loliamro/guardband-ai-fall-detection/5.JPG

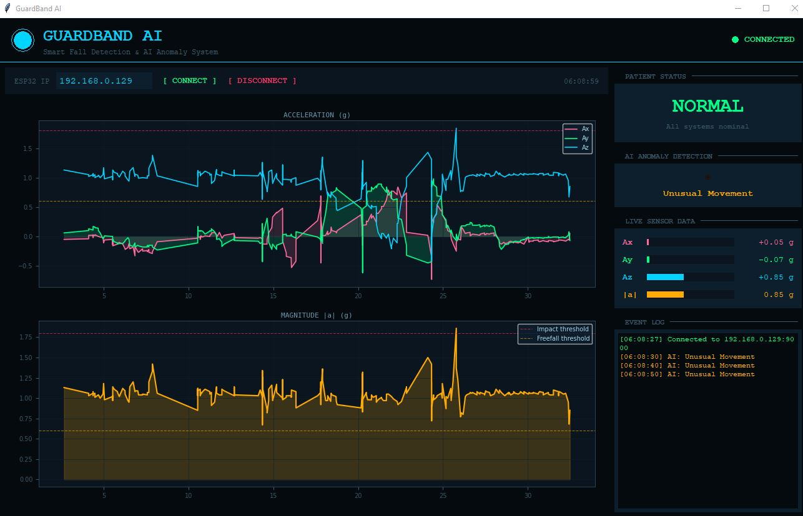
5.JPG
