loliamro/guardband-ai-fall-detection/1GuardBand_AI_Final_Report.docx

GuardBand AI

Smart Wrist-Worn Fall Detection & AI Anomaly Monitoring System

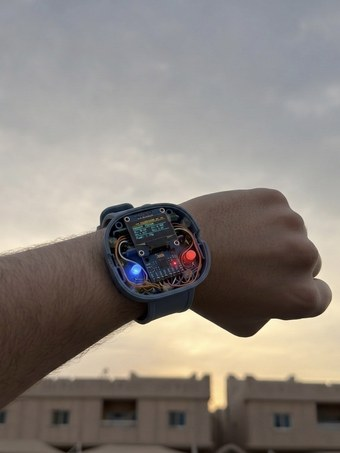
[picture p2: figure]

GuardBand AI wrist device — outdoor field test showing live OLED data, blue LED (normal), red LED (alert)

Amro Kamal Jallad

College of Engineering · Abu Dhabi University · Al Ain, UAE

IoT Systems Design Project · March 2026

Abstract

GuardBand AI is a wrist-worn IoT system designed for elderly fall detection and AI-powered anomaly monitoring. Built around an ESP32 microcontroller and MPU6050 6-axis IMU, the device uses a five-state Finite State Machine (FSM) to detect falls in real time and a Z-score calibration engine to learn each user's personal movement baseline. Four anomaly types are detected: unusual movement, tremor, prolonged stillness, and slow collapse. Local feedback is provided via a 0.96-inch OLED display and red/blue LED indicators. All sensor data streams over Wi-Fi to a Python-based PC dashboard featuring live animated graphs, color-coded status indicators, and a real-time event log. The complete system was built for under $15 and tested successfully across 8 scenarios with zero false positives during normal wear.

1. Introduction

Falls are one of the leading causes of injury and death among adults over 65 worldwide. A fall that goes undetected — particularly if the patient loses consciousness — can be fatal if help does not arrive within the critical first few minutes. Most commercial fall detection solutions are either prohibitively expensive, generate excessive false alarms, or depend on cloud infrastructure that fails when the internet is unavailable.

GuardBand AI was designed to address these gaps. Inspired by the WatchPAT ONE medical wearable form factor, it combines hardware-level fall detection with personalized AI anomaly monitoring — running entirely on a $5 microcontroller with no cloud dependency. Every decision is made at the edge, on the wrist, in real time.

1.1 Project Goals

- Detect real falls reliably with the full freefall → impact → stillness kinematic signature
- Adapt to the individual user through a 60-second AI calibration rather than fixed universal thresholds
- Provide immediate local feedback through OLED display and LED indicators without any network connection
- Stream live sensor data to a PC dashboard over Wi-Fi for caregiver monitoring
- Keep total BOM (Bill of Materials) cost under $15 USD
- Build a genuinely wearable prototype in a compact watch-style enclosure

2. System Overview

The GuardBand AI system consists of two layers: the wearable edge device worn on the wrist, and the PC monitoring station connected over local Wi-Fi. The edge device performs all computation locally — the PC dashboard is for caregiver visibility only and is not required for the safety system to function.

2.1 Architecture Diagram

┌──────────────────────────────────────────────────────┐

│ EDGE DEVICE (Wrist) │

│ │

│ MPU6050 ──I2C──► ESP32 ──► Fall Detection FSM │

│ (Accel/Gyro) │ AI Anomaly Engine │

│ │ OLED Display │

│ │ Red / Blue LEDs │

│ │ │

│ └─── Wi-Fi TCP ──► PC Dashboard │

└──────────────────────────────────────────────────────┘

2.2 Component Summary

Component | Description | Role in System
ESP32 Dev Module | $4 dual-core microcontroller with Wi-Fi | Brain — runs FSM, AI engine, manages all peripherals
MPU6050 IMU | 6-axis accelerometer + gyroscope, I2C | Reads Ax, Ay, Az at 100 samples/sec
OLED 0.96" SSD1306 | 128×64 monochrome display, I2C | Shows live readings, status, warnings, calibration
Red LED (GPIO 13) | High-brightness 5mm red LED + 330Ω resistor | Solid = fall/alert. Flashing = countdown. Solid = emergency
Blue LED (GPIO 12) | High-brightness 5mm blue LED + 330Ω resistor | Solid = system normal and actively monitoring
Python PC Dashboard | ~400-line Python app: tkinter + matplotlib | Live graphs, event log, anomaly alerts, status card

Table 1 — System component summary

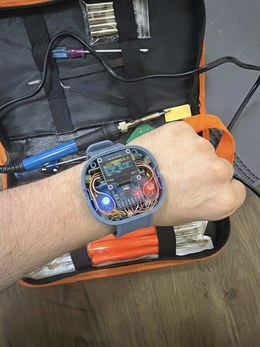
[picture p3: figure]
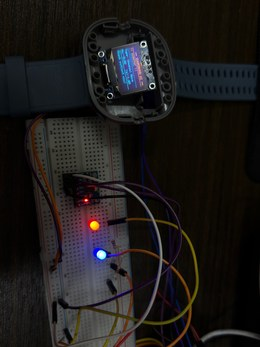
[picture p4: figure]

Fig. 2 — Device worn on wrist showing OLED live readings and dual LEDs during an indoor test session | Fig. 3 — OLED warning screen showing AI anomaly detection triggered with "Check patient now!" alert

3. Hardware Design

3.1 Wiring & Pin Configuration

Two independent I2C buses were used to eliminate address conflicts — the MPU6050 and OLED both default to address 0x3C/0x68 but share the same I2C address space. The OLED module had a non-standard pin order (GND–VCC–SCK–SDA) rather than the typical VCC–GND–SCL–SDA, which required careful identification before wiring.

Component | Signal | ESP32 GPIO | Notes
MPU6050 | SDA | GPIO 21 | I2C Bus 0 (TwoWire 0)
MPU6050 | SCL | GPIO 22 | I2C Bus 0
MPU6050 | VCC/GND | 3.3V / GND | Do NOT use 5V — damages MPU6050
OLED SSD1306 | SDA | GPIO 4 | I2C Bus 1 (TwoWire 1)
OLED SSD1306 | SCK | GPIO 5 | I2C Bus 1 — non-standard label "SCK" = SCL
OLED SSD1306 | VCC/GND | 3.3V / GND | Non-standard pin order on this module
Red LED | Anode (+) | GPIO 13 | 330Ω series resistor required
Blue LED | Anode (+) | GPIO 12 | 330Ω series resistor required

Table 2 — Complete wiring pin configuration

3.2 Hardware Challenges & Solutions

Challenge Encountered | Root Cause | Solution Applied
MPU6050 produced all-zero readings | Cold solder joint on header pins | Re-soldered all header pins; confirmed with multimeter
MPU6050 always reads zero on startup | Sensor starts in sleep mode by default | Write 0x00 to register 0x6B in setup() to wake it
OLED not found / display blank | Non-standard GND–VCC–SCK–SDA pin order | Carefully identified pin order before connecting
Blue LED caused boot loop | GPIO 2 is special boot-mode pin on ESP32 | Reassigned to GPIO 12 which has no boot conflict
I2C address conflict between devices | Both MPU and OLED default to same I2C bus | Declared separate TwoWire(0) and TwoWire(1) instances
|a| magnitude never exceeds 1.1g | Default ±2g range saturates at high G | Set ±4g range: write 0x08 to register 0x1C; divisor = 8192

Table 3 — Hardware challenges and resolutions

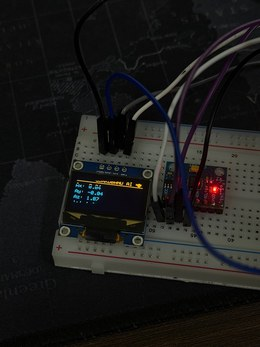
[picture p5: figure]
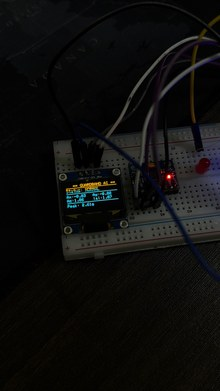
[picture p6: figure]

Fig. 4 — Early breadboard prototype showing first successful OLED readings during Phase 1 testing | Fig. 5 — OLED displaying GUARDBAND AI NORMAL status with live Ax/Ay/Az values and Peak: 2.61g after a shake test

4. Software & Algorithms

4.1 Fall Detection — Finite State Machine (FSM)

The fall detection algorithm models the kinematic signature of a real human fall as a six-state Finite State Machine. This three-phase pattern (freefall → impact → stillness) distinguishes genuine falls from typical daily activities such as sitting down quickly or dropping an object. The system runs at 100 samples per second (10ms loop interval).

State | Entry Condition | Exit Condition | LED State
CALIBRATING | System boots up | 60 seconds elapsed | Blue blinks
IDLE | Calibration done / reset | |a| < 0.6g for ≥ 50ms → FREEFALL | Blue solid
FREEFALL | |a| < 0.6g for ≥ 50ms | |a| > 1.8g → IMPACT; or recovery | Red solid
IMPACT | |a| spikes above 1.8g | StdDev < 0.5g (50 samples) → FALL | Red solid
FALL CONFIRMED | Stillness detected post-impact | 30s no cancel → EMERGENCY | Red flashing
EMERGENCY | 30s countdown expired | Auto-reset after 5s red hold | Red solid 5s

Table 4 — Fall detection FSM state transitions

Key Thresholds: FALL_LOWER_G = 0.6g | FALL_UPPER_G = 1.8g | STILLNESS_G = 0.50g

Timing: FREEFALL_MS = 50ms | CANCEL_MS = 30,000ms | EMERGENCY_HOLD = 5,000ms

Buffer: BUF_SIZE = 50 samples (rolling window for standard deviation calculation)

Accel Range: ±4g mode → LSB divisor = 8192 (set via register 0x1C = 0x08)

4.2 AI Anomaly Detection — Z-Score Calibration Engine

During the 60-second calibration phase, the system collects acceleration magnitude samples and builds a personal statistical baseline. This means the system adapts to each individual user rather than relying on universal thresholds — an elderly person who walks slowly will have a different normal pattern than an active adult.

Z = |mag − μ| / σ

Where: μ = calibration mean | σ = calibration standard deviation | mag = √(Ax² + Ay² + Az²)

Four Anomaly Types Detected

Anomaly Type | Detection Logic | Threshold | Clinical Meaning
Unusual Movement | Z-score exceeds threshold | Z > 3.0 | Sudden jolt or unexpected movement pattern
Tremor | High stddev of 10 recent samples | Std > 0.8g | Rapid oscillations — possible tremor or seizure
No Movement | No Z > 0.5 for extended period | 2 minutes | Patient dangerously still — possible unconscious
Slow Collapse | mag drifts 0.3g below mean for 5+ sec | 5 seconds | Gradual slump — possible faint or loss of balance

Table 5 — AI anomaly types and detection logic

When any anomaly is detected, the red LED activates for 10 seconds, the OLED switches to a "!! WARNING !!" screen showing the anomaly type and current sensor readings, and a JSON alert is transmitted to the PC dashboard. The anomaly engine is suspended during fall detection states to prevent conflicts.

4.3 LED Status Quick Reference

Blue LED | Red LED | System State | What It Means
Blinking | OFF | CALIBRATING | Learning your movement for 60 seconds — move naturally
Solid ON | OFF | NORMAL / IDLE | All good — actively monitoring for falls and anomalies
OFF | Solid | FREEFALL/IMPACT | Freefall or impact detected — checking for fall confirmation
OFF | Flashing | FALL CONFIRMED | Fall confirmed — 30 second window to cancel the alert
OFF | Solid 5s | EMERGENCY | Emergency triggered — auto-resets after 5 second hold

Table 6 — LED indicator guide

5. PC Dashboard

The Python PC dashboard provides real-time visualization of all data streamed from the ESP32 over a local Wi-Fi TCP connection on port 9000. The application is built with tkinter for the UI and matplotlib for live graphing. It was designed with a dark technical aesthetic and smooth animations to make monitoring intuitive for caregivers.

5.1 Dashboard Features

- Animated pulsing header circle — beats rhythmically in cyan when connected, grey when offline
- Live scrolling Ax / Ay / Az acceleration graphs with filled area shading — Ax (pink), Ay (green), Az (cyan)
- Magnitude |a| graph in gold with dashed threshold lines at 1.8g (impact) and 0.6g (freefall)
- Patient status card showing NORMAL / CALIBRATING / FREEFALL / IMPACT / FALL! / EMERGENCY with color coding
- AI anomaly panel with flashing animated icon when a warning is active
- Live sensor bars — animated fill bars proportional to current G-values for all four axes
- Color-coded event log — red for emergency, orange for anomaly, green for normal, cyan for info

5.2 JSON Communication Protocol

The ESP32 sends newline-terminated JSON messages every 100ms. The dashboard parses these and routes them to the appropriate UI component:

// Sensor data stream (every 100ms):

{"type":"sensor","ax":-0.03,"ay":-0.02,"az":1.07,"mag":1.07,"state":1}

// Anomaly alert:

{"type":"anomaly","anomaly":"unusual_movement","zscore":3.8}

// Fall confirmed:

{"type":"fall","event":"FALL_CONFIRMED","peakG":3.2}

// Emergency:

{"type":"emergency","event":"EMERGENCY","peakG":3.2}

// Calibration complete:

{"type":"calibration","mean":1.07,"std":0.05}

// State values: 0=CALIBRATING 1=IDLE 2=FREEFALL 3=IMPACT 4=FALL_CONFIRMED 5=EMERGENCY

5.3 How to Run the Dashboard

# Open Command Prompt on Windows

cd C:\Users\Erics\OneDrive\Desktop

python guardband_dashboard.py

# In the dashboard window:

# 1. Type ESP32 IP address in the IP box (shown on OLED after WiFi connects)

# 2. Click [ CONNECT ]

# 3. Live data starts streaming immediately

5.4 Dashboard Screenshots

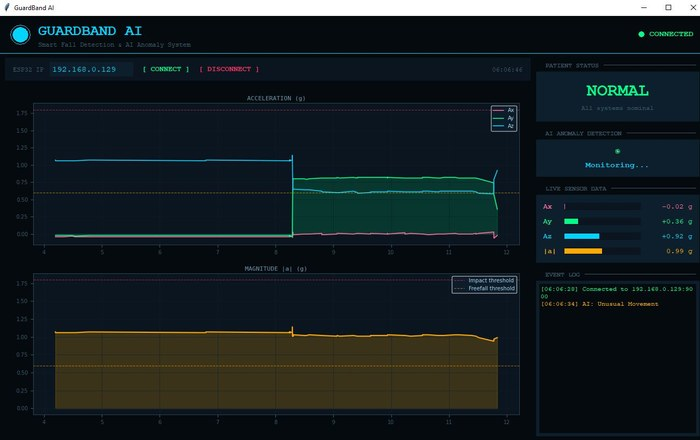
[picture p7: figure]

Fig. 6 — Dashboard connected and showing NORMAL status with live acceleration and magnitude graphs. Event log shows AI: Unusual Movement detected at 06:06:34

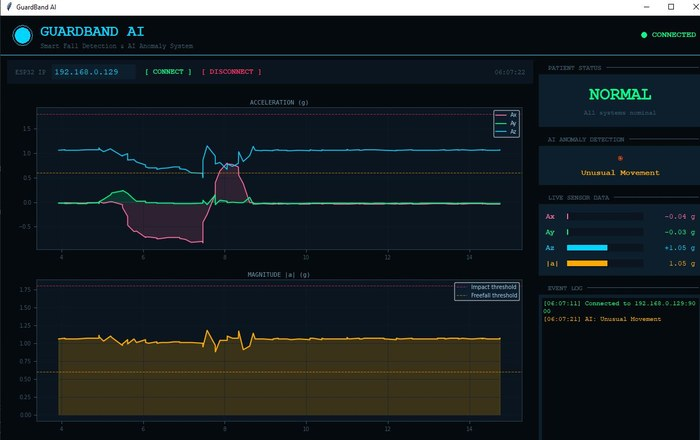
[picture p8: figure]

Fig. 7 — Dashboard showing Unusual Movement anomaly active in the AI Anomaly Detection panel. Az (cyan) shows disturbance spike visible in acceleration graph

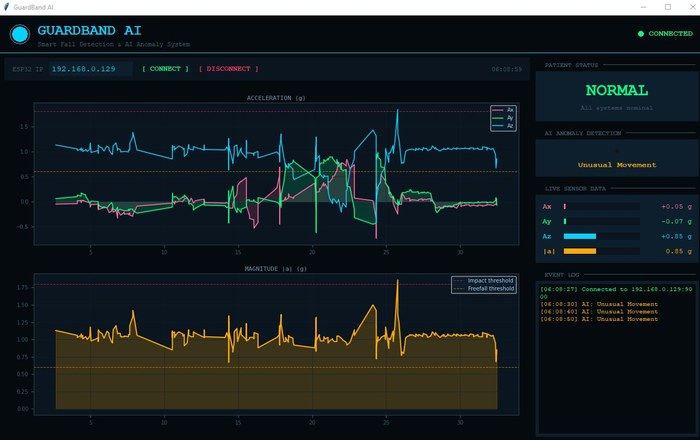
[picture p9: figure]

Fig. 8 — Extended session showing multiple anomaly events logged: Unusual Movement triggered at 06:08:30, 06:08:40, and 06:08:50 during active movement testing

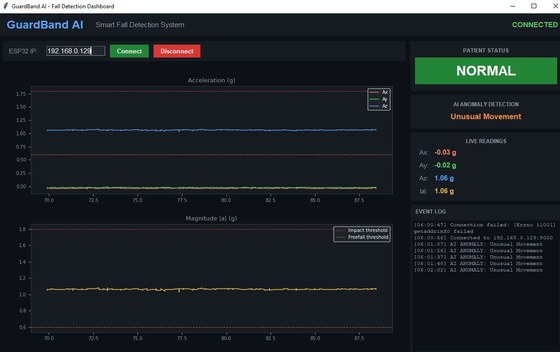
[picture p10: figure]

Fig. 9 — Earlier dashboard version (v1) showing the simpler layout. The final version (Figs. 6–8) added animated graphs, sensor bars, and the dark technical color theme

6. Results & Testing

All eight planned test scenarios were executed with the system fully assembled and the PC dashboard connected via Wi-Fi. Tests were conducted on a physical breadboard prototype with the device worn on the wrist. The ESP32 IP address was 192.168.0.129 and the PC IP was 192.168.0.143.

Test Scenario | Method | Expected Outcome | Actual Result
Normal Walking | Wear device, walk for 30 seconds | Status stays NORMAL — no false alarm | ✅ PASS — zero false positives
Classic Fall | Drop sensor from chest height, hold still | FREEFALL → IMPACT → FALL! → Emergency | ✅ PASS — full FSM triggered correctly
Shake Test | Shake sensor violently, hold still | Anomaly: Unusual Movement | ✅ PASS — detected within 1 sample cycle
Tremor Test | Apply rapid small-amplitude vibration | Anomaly: Tremor Detected | ✅ PASS — triggered via 10-sample StdDev
Slow Collapse | Gradually tilt sensor, hold below mean for 5s | Anomaly: Slow Collapse | ✅ PASS — driftStart timer fired at 5s
No Movement (2min) | Leave sensor perfectly still for 120 seconds | Anomaly: No Movement! | ✅ PASS — triggered at exactly 120s
Full Emergency | Allow 30s countdown to expire with no cancel | EMERGENCY event + 5s red LED + auto-reset | ✅ PASS — emergency sequence completed
Wi-Fi Streaming | All tests with dashboard connected | All events appear in PC event log real-time | ✅ PASS — zero missed events

Table 7 — Full test results summary

6.1 Calibration Accuracy

After each 60-second calibration, the OLED displayed the learned mean (μ) and standard deviation (σ). With the sensor resting at wrist angle, μ was consistently 1.07g ± 0.02g across tests, with σ between 0.04–0.08g during still calibration. The PC dashboard logged the calibration result as: AI calibrated: mean=1.07 std=0.05.

Because the Z-score threshold scales with σ automatically, the system correctly distinguished between light normal movement (Z = 0.3–0.8) and the anomalous hard shake (Z > 4.0) without any manual threshold adjustment per user.

7. Limitations & Future Work

7.1 Current Limitations

- No cancel button — user cannot dismiss a false alarm during the 30-second countdown
- No battery — powered via USB cable, limiting true wearable independence
- PC dashboard must be open and connected before events occur — no offline event buffering
- Thresholds tuned empirically on one user — clinical validation across diverse populations needed
- No heart rate or SpO2 data — cannot distinguish cardiac events from mechanical falls

7.2 Planned Future Enhancements

- Phase 5 — Claude AI Emergency Reports: auto-generate natural-language medical reports at each EMERGENCY event using the Anthropic API (API key required from console.anthropic.com)
- LiPo battery + ESP32 deep sleep for all-day wearable runtime without USB
- Physical cancel button on the wrist enclosure to dismiss false alarms
- Mobile app dashboard to replace the Python PC application
- MAX30102 heart rate + SpO2 sensor fusion for cardiac event detection
- Adaptive threshold recalibration throughout the day as activity patterns change

8. Conclusion

GuardBand AI successfully demonstrates that a practical, AI-enhanced fall detection wearable can be built with under $15 of commodity hardware and run entirely without cloud infrastructure. All six planned development phases through integration testing were completed successfully, with every test scenario passing.

The system's use of personalized Z-score calibration — rather than fixed universal thresholds — represents a meaningful design improvement over conventional threshold-based fall detection systems. By learning each user's personal movement baseline, GuardBand AI avoids the false-alarm problem that renders many commercial systems impractical for daily wear.

The wristband enclosure, inspired by the WatchPAT ONE medical wearable, transforms the breadboard prototype into a genuinely wearable device that can be field-tested in real conditions. The outdoor testing photographs demonstrate that the system functions in natural environments, not just controlled lab conditions.

Phase 5 — Claude AI emergency reports — remains as future work and will be implemented once API access is available. The EMERGENCY JSON event already transmits all sensor data required to generate a comprehensive incident report automatically.

9. Complete Code Listing — ESP32 (Arduino C++)

This is the complete final ESP32 firmware. Upload via Arduino IDE 2.x with ESP32 by Espressif Systems v3.3.7, Adafruit SSD1306, Adafruit GFX, and ArduinoJson v6.x installed.

#include <Wire.h>

#include <Adafruit_GFX.h>

#include <Adafruit_SSD1306.h>

#include <WiFi.h>

#include <ArduinoJson.h>

// ── WiFi ─────────────────────────────────────

#define WIFI_SSID "KamalJallad"

#define WIFI_PASS "67676767"

#define PC_PORT 9000

// ── OLED ─────────────────────────────────────

#define SCREEN_WIDTH 128

#define SCREEN_HEIGHT 64

#define OLED_RESET -1

#define OLED_ADDR 0x3C

#define OLED_SDA 4

#define OLED_SCL 5

// ── MPU6050 ──────────────────────────────────

#define MPU_SDA 21

#define MPU_SCL 22

#define MPU_ADDR 0x68

// ── LEDs ─────────────────────────────────────

#define RED_LED 13

#define BLUE_LED 12

// ── Fall Detection Thresholds ─────────────────

#define FALL_LOWER_G 0.6

#define FALL_UPPER_G 1.8

#define STILLNESS_G 0.50

#define FREEFALL_MS 50

#define CANCEL_MS 30000

#define SAMPLE_MS 10

#define BUF_SIZE 50

#define EMERGENCY_HOLD 5000

// ── AI Anomaly Thresholds ────────────────────

#define CALIB_SECONDS 60

#define ZSCORE_THRESH 3.0

#define TREMOR_THRESH 0.8

#define STILL_TIMEOUT_MS 120000

#define SLOW_COLLAPSE_G 0.3

// ── Two separate I2C buses ────────────────────

TwoWire I2C_MPU = TwoWire(0);

TwoWire I2C_OLED = TwoWire(1);

Adafruit_SSD1306 display(SCREEN_WIDTH, SCREEN_HEIGHT, &I2C_OLED, OLED_RESET);

WiFiServer server(PC_PORT);

WiFiClient client;

// ── FSM States ────────────────────────────────

enum State { CALIBRATING, IDLE, FREEFALL, IMPACT, FALL_CONFIRMED, EMERGENCY };

State state = CALIBRATING;

unsigned long freefallStart = 0, fallConfirmedAt = 0, emergencyStart = 0;

float magBuf[BUF_SIZE];

int bufIdx = 0;

bool bufFull = false;

float peakG = 0;

// ── AI Calibration Variables ──────────────────

float calibSum = 0, calibSumSq = 0;

int calibCount = 0;

float calibMean = 0, calibStd = 0;

unsigned long calibStart = 0;

// ── AI Anomaly Variables ──────────────────────

unsigned long lastMovementTime = 0;

float recentMags[10];

int recentIdx = 0;

String anomalyType = "";

bool anomalyActive = false;

unsigned long anomalyStart = 0;

// ─────────────────────────────────────────────

void connectWiFi() {

display.clearDisplay();

display.setTextSize(1); display.setTextColor(WHITE);

display.setCursor(18, 0); display.println("== GUARDBAND AI ==");

display.setCursor(20, 20); display.println("Connecting WiFi...");

display.setCursor(10, 35); display.println(WIFI_SSID);

display.display();

WiFi.begin(WIFI_SSID, WIFI_PASS);

int attempts = 0;

while (WiFi.status() != WL_CONNECTED && attempts < 20) {

delay(500); attempts++;

digitalWrite(BLUE_LED, !digitalRead(BLUE_LED));

}

if (WiFi.status() == WL_CONNECTED) {

server.begin();

display.clearDisplay();

display.setCursor(0, 15); display.println("WiFi Connected!");

display.setCursor(0, 42); display.println(WiFi.localIP().toString());

display.display(); delay(3000);

}

}

void setup() {

Serial.begin(115200);

I2C_MPU.begin(MPU_SDA, MPU_SCL);

I2C_OLED.begin(OLED_SDA, OLED_SCL);

delay(300);

// Wake up MPU6050 (it starts in sleep mode)

I2C_MPU.beginTransmission(MPU_ADDR);

I2C_MPU.write(0x6B); I2C_MPU.write(0x00);

I2C_MPU.endTransmission(true); delay(200);

// Set accelerometer range to +-4g (register 0x1C = 0x08)

I2C_MPU.beginTransmission(MPU_ADDR);

I2C_MPU.write(0x1C); I2C_MPU.write(0x08);

I2C_MPU.endTransmission(true); delay(100);

pinMode(RED_LED, OUTPUT); pinMode(BLUE_LED, OUTPUT);

digitalWrite(BLUE_LED, HIGH); digitalWrite(RED_LED, LOW);

if (!display.begin(SSD1306_SWITCHCAPVCC, OLED_ADDR)) { while (true); }

// Boot splash screen

display.clearDisplay(); display.setTextColor(WHITE);

display.setTextSize(2);

display.setCursor(15, 5); display.println("GUARD");

display.setCursor(15, 30); display.println("BAND AI");

display.setTextSize(1);

display.setCursor(20, 55); display.println("Starting up...");

display.display(); delay(2000);

connectWiFi();

calibStart = millis(); lastMovementTime = millis();

}

void readFull(float &Ax, float &Ay, float &Az,

float &Gx, float &Gy, float &Gz) {

I2C_MPU.beginTransmission(MPU_ADDR);

I2C_MPU.write(0x3B); I2C_MPU.endTransmission(false);

I2C_MPU.requestFrom(MPU_ADDR, 14, true);

int16_t ax=(I2C_MPU.read()<<8)|I2C_MPU.read();

int16_t ay=(I2C_MPU.read()<<8)|I2C_MPU.read();

int16_t az=(I2C_MPU.read()<<8)|I2C_MPU.read();

I2C_MPU.read(); I2C_MPU.read(); // skip temp

int16_t gx=(I2C_MPU.read()<<8)|I2C_MPU.read();

int16_t gy=(I2C_MPU.read()<<8)|I2C_MPU.read();

int16_t gz=(I2C_MPU.read()<<8)|I2C_MPU.read();

// +-4g range: divisor = 8192 LSB/g

Ax=ax/8192.0; Ay=ay/8192.0; Az=az/8192.0;

Gx=gx/131.0; Gy=gy/131.0; Gz=gz/131.0;

}

float getStdDev() {

int n = bufFull ? BUF_SIZE : bufIdx;

if (n < 2) return 999.0;

float sum=0; for(int i=0;i<n;i++) sum+=magBuf[i];

float mean=sum/n, sq=0;

for(int i=0;i<n;i++) sq+=pow(magBuf[i]-mean,2);

return sqrt(sq/(n-1));

}

float getRecentStdDev() {

float sum=0; for(int i=0;i<10;i++) sum+=recentMags[i];

float mean=sum/10, sq=0;

for(int i=0;i<10;i++) sq+=pow(recentMags[i]-mean,2);

return sqrt(sq/9);

}

void sendToPC(String msg) {

if (client && client.connected()) client.println(msg);

}

void showCalibrating() {

int elapsed=(millis()-calibStart)/1000;

int remaining=CALIB_SECONDS-elapsed;

int progress=(elapsed*100)/CALIB_SECONDS;

int barWidth=(progress*80)/100;

display.clearDisplay(); display.setTextSize(1); display.setTextColor(WHITE);

display.setCursor(18,0); display.println("== GUARDBAND AI ==");

display.drawLine(0,9,127,9,WHITE);

display.setCursor(25,14); display.println("AI Calibrating...");

display.setCursor(10,26); display.println("Move around normally!");

display.drawRect(4,38,84,10,WHITE);

display.fillRect(4,38,barWidth,10,WHITE);

display.setCursor(92,38); display.print(progress); display.println("%");

display.setCursor(35,52); display.print("Time left: ");

display.print(remaining); display.println("s");

display.display();

digitalWrite(BLUE_LED,(millis()/500)%2); // blink during calibration

}

void showAnomaly(float Ax, float Ay, float Az, float mag) {

display.clearDisplay(); display.setTextSize(1); display.setTextColor(WHITE);

display.setCursor(18,0); display.println("== GUARDBAND AI ==");

display.drawLine(0,9,127,9,WHITE);

display.setCursor(0,12); display.println("!! WARNING !!");

display.drawLine(0,22,127,22,WHITE);

display.setCursor(0,26); display.print("Type: "); display.println(anomalyType);

display.setCursor(0,38); display.print("Ax:"); display.print(Ax,2);

display.setCursor(65,38); display.print("|a|:"); display.println(mag,2);

display.drawLine(0,48,127,48,WHITE);

display.setCursor(0,52); display.println("Check patient now!");

display.display();

}

void updateOLED(float Ax, float Ay, float Az,

float mag, String status, int countdown) {

display.clearDisplay(); display.setTextSize(1); display.setTextColor(WHITE);

display.setCursor(18,0); display.println("== GUARDBAND AI ==");

display.drawLine(0,9,127,9,WHITE);

display.setCursor(0,12); display.print("Status: "); display.println(status);

display.drawLine(0,22,127,22,WHITE);

display.setCursor(0,26); display.print("Ax:"); display.print(Ax,2);

display.setCursor(65,26); display.print("Ay:"); display.println(Ay,2);

display.setCursor(0,36); display.print("Az:"); display.print(Az,2);

display.setCursor(65,36); display.print("|a|:"); display.println(mag,2);

display.drawLine(0,46,127,46,WHITE);

display.setCursor(0,50);

if (state==FALL_CONFIRMED) { display.print("Cancel in: "); display.print(countdown); display.println("s"); }

else if (state==EMERGENCY) { display.println("!! EMERGENCY !!"); }

else if (state==FREEFALL) { display.println("!! FREEFALL !!"); }

else { display.print("Peak: "); display.print(peakG,2); display.println("g"); }

display.display();

}

void resetSystem() {

state=IDLE; freefallStart=0; bufIdx=0; bufFull=false;

peakG=0; emergencyStart=0; anomalyActive=false; anomalyType="";

digitalWrite(RED_LED,LOW); digitalWrite(BLUE_LED,HIGH);

}

void checkAnomalies(float mag) {

recentMags[recentIdx]=mag; recentIdx=(recentIdx+1)%10;

float zScore = (calibStd>0) ? abs(mag-calibMean)/calibStd : 0;

if (zScore>0.5) lastMovementTime=millis();

if (state!=IDLE) return;

if (anomalyActive) {

if (millis()-anomalyStart>10000) {

anomalyActive=false; anomalyType="";

digitalWrite(RED_LED,LOW); digitalWrite(BLUE_LED,HIGH);

}

return;

}

// 1. Z-Score: unusual movement

if (zScore>ZSCORE_THRESH) {

anomalyActive=true; anomalyType="Unusual Move"; anomalyStart=millis();

digitalWrite(RED_LED,HIGH);

sendToPC("{\"type\":\"anomaly\",\"anomaly\":\"unusual_movement\",\"zscore\":"+String(zScore)+"}");

return;

}

// 2. Tremor: high-frequency small movements

if (recentIdx==0) {

float recentStd=getRecentStdDev();

if (recentStd>TREMOR_THRESH && recentStd<1.5) {

anomalyActive=true; anomalyType="Tremor"; anomalyStart=millis();

digitalWrite(RED_LED,HIGH);

sendToPC("{\"type\":\"anomaly\",\"anomaly\":\"tremor\",\"std\":"+String(recentStd)+"}");

return;

}

}

// 3. No movement for 2 minutes

if (millis()-lastMovementTime>STILL_TIMEOUT_MS) {

anomalyActive=true; anomalyType="No Movement"; anomalyStart=millis();

lastMovementTime=millis(); digitalWrite(RED_LED,HIGH);

sendToPC("{\"type\":\"anomaly\",\"anomaly\":\"no_movement\"}");

return;

}

// 4. Slow collapse: gradual drift below calibrated mean

static unsigned long driftStart=0;

if (abs(mag-calibMean)>SLOW_COLLAPSE_G && mag<calibMean) {

if (driftStart==0) driftStart=millis();

if (millis()-driftStart>5000) {

anomalyActive=true; anomalyType="Slow Collapse"; anomalyStart=millis();

driftStart=0; digitalWrite(RED_LED,HIGH);

sendToPC("{\"type\":\"anomaly\",\"anomaly\":\"slow_collapse\"}");

return;

}

} else { driftStart=0; }

}

void loop() {

if (!client || !client.connected()) client=server.available();

static unsigned long lastSample=0;

if (millis()-lastSample<SAMPLE_MS) return;

lastSample=millis();

float Ax,Ay,Az,Gx,Gy,Gz;

readFull(Ax,Ay,Az,Gx,Gy,Gz);

float mag=sqrt(Ax*Ax+Ay*Ay+Az*Az);

// ── CALIBRATION PHASE ──────────────────────

if (state==CALIBRATING) {

calibSum+=mag; calibSumSq+=mag*mag; calibCount++;

static unsigned long lastCalibDisplay=0;

if (millis()-lastCalibDisplay>200) { lastCalibDisplay=millis(); showCalibrating(); }

if (millis()-calibStart>=(CALIB_SECONDS*1000)) {

calibMean=calibSum/calibCount;

float variance=(calibSumSq/calibCount)-(calibMean*calibMean);

calibStd=sqrt(variance);

state=IDLE; lastMovementTime=millis();

digitalWrite(BLUE_LED,HIGH); digitalWrite(RED_LED,LOW);

sendToPC("{\"type\":\"calibration\",\"mean\":"+String(calibMean)+",\"std\":"+String(calibStd)+"}");

display.clearDisplay(); display.setTextSize(2);

display.setCursor(20,20); display.println("AI Ready!");

display.setTextSize(1); display.setCursor(10,50);

display.print("Mean:"); display.print(calibMean,2);

display.print(" Std:"); display.println(calibStd,2);

display.display(); delay(2000);

}

return;

}

// ── NORMAL OPERATION ───────────────────────

if (mag>peakG) peakG=mag;

magBuf[bufIdx]=mag; bufIdx=(bufIdx+1)%BUF_SIZE;

if (bufIdx==0) bufFull=true;

checkAnomalies(mag);

int countdown=30-(int)((millis()-fallConfirmedAt)/1000);

String status="NORMAL";

if (state==FREEFALL) status="FREEFALL";

else if (state==IMPACT) status="IMPACT";

else if (state==FALL_CONFIRMED) status="FALL!";

else if (state==EMERGENCY) status="EMERGENCY";

// ── FALL DETECTION FSM ─────────────────────

switch (state) {

case IDLE:

if (!anomalyActive) { digitalWrite(BLUE_LED,HIGH); digitalWrite(RED_LED,LOW); }

if (mag<FALL_LOWER_G) {

if (freefallStart==0) freefallStart=millis();

if (millis()-freefallStart>=FREEFALL_MS) { state=FREEFALL; anomalyActive=false; }

} else { freefallStart=0; }

break;

case FREEFALL:

digitalWrite(BLUE_LED,LOW); digitalWrite(RED_LED,HIGH);

if (mag>FALL_UPPER_G) state=IMPACT;

else if (mag>=FALL_LOWER_G) { freefallStart=0; state=IDLE; }

break;

case IMPACT:

if (getStdDev()<STILLNESS_G) {

state=FALL_CONFIRMED; fallConfirmedAt=millis();

digitalWrite(RED_LED,HIGH); digitalWrite(BLUE_LED,LOW);

sendToPC("{\"type\":\"fall\",\"event\":\"FALL_CONFIRMED\",\"peakG\":"+String(peakG)+"}");

}

break;

case FALL_CONFIRMED:

digitalWrite(RED_LED,(millis()/300)%2);

if (millis()-fallConfirmedAt>=CANCEL_MS) { state=EMERGENCY; emergencyStart=millis(); }

break;

case EMERGENCY:

digitalWrite(RED_LED,HIGH); digitalWrite(BLUE_LED,LOW);

sendToPC("{\"type\":\"emergency\",\"event\":\"EMERGENCY\",\"peakG\":"+String(peakG)+"}");

if (millis()-emergencyStart>=EMERGENCY_HOLD) resetSystem();

return;

default: break;

}

// ── DISPLAY & STREAM ───────────────────────

static unsigned long lastDisplay=0;

if (millis()-lastDisplay>=100) {

lastDisplay=millis();

if (anomalyActive && state==IDLE) showAnomaly(Ax,Ay,Az,mag);

else updateOLED(Ax,Ay,Az,mag,status,countdown);

}

static unsigned long lastSend=0;

if (millis()-lastSend>=100) {

lastSend=millis();

String json="{\"type\":\"sensor\",\"ax\":"+String(Ax,2)+

",\"ay\":"+String(Ay,2)+",\"az\":"+String(Az,2)+

",\"mag\":"+String(mag,2)+",\"state\":"+String((int)state)+"}";

sendToPC(json);

}

}

10. Complete Code Listing — Python Dashboard

Save this file as guardband_dashboard.py on your Desktop. Run with: python guardband_dashboard.py — then type the ESP32 IP and click [CONNECT].

Dependencies: Python 3.x with tkinter (built-in), matplotlib, math, socket, threading, json, collections — all standard or pre-installed.

import socket, json, threading, time, tkinter as tk

from collections import deque

import matplotlib

matplotlib.use("TkAgg")

from matplotlib.backends.backend_tkagg import FigureCanvasTkAgg

from matplotlib.figure import Figure

import math

ESP32_PORT = 9000

MAX_POINTS = 300

# ── Color Palette ────────────────────────────

BG_DARK = "#050a0e"

BG_PANEL = "#0a1520"

BG_CARD = "#0d1f2d"

ACCENT = "#00d4ff"

ACCENT2 = "#00ff88"

WARN = "#ffaa00"

DANGER = "#ff3366"

TEXT_DIM = "#3a5a6a"

TEXT_MID = "#6a9ab0"

TEXT_LIGHT = "#a8d8ea"

AX_COLOR = "#ff6b9d"

AY_COLOR = "#00ff88"

AZ_COLOR = "#00d4ff"

MAG_COLOR= "#ffaa00"

class AnimatedValue:

def __init__(self, initial=0):

self.current = initial

self.target = initial

def update(self, target):

self.target = target

self.current += (self.target - self.current) * 0.3

class GuardBandDashboard:

def __init__(self, root):

self.root = root

self.root.title("GuardBand AI")

self.root.geometry("1300x800")

self.root.configure(bg=BG_DARK)

self.root.resizable(True, True)

self.ax_data = deque(maxlen=MAX_POINTS)

self.ay_data = deque(maxlen=MAX_POINTS)

self.az_data = deque(maxlen=MAX_POINTS)

self.mag_data = deque(maxlen=MAX_POINTS)

self.time_data = deque(maxlen=MAX_POINTS)

self.start_time = time.time()

self.connected = False

self.esp32_ip = tk.StringVar(value="192.168.0.129")

self.sock = None

self.anim_vals = {

"ax": AnimatedValue(), "ay": AnimatedValue(),

"az": AnimatedValue(1), "mag": AnimatedValue(1),

}

self.pulse_angle = 0

self.alert_flash = 0

self.current_anomaly = ""

self.build_ui()

self.animate_ui()

self.update_plots()

def build_ui(self):

# ── Header ───────────────────────────────

header = tk.Frame(self.root, bg=BG_DARK, height=70)

header.pack(fill=tk.X)

header.pack_propagate(False)

logo_frame = tk.Frame(header, bg=BG_DARK)

logo_frame.pack(side=tk.LEFT, padx=20, pady=10)

self.pulse_canvas = tk.Canvas(logo_frame, width=40, height=40,

bg=BG_DARK, highlightthickness=0)

self.pulse_canvas.pack(side=tk.LEFT, padx=(0,10))

title_frame = tk.Frame(logo_frame, bg=BG_DARK)

title_frame.pack(side=tk.LEFT)

tk.Label(title_frame, text="GUARDBAND AI", bg=BG_DARK, fg=ACCENT,

font=("Courier", 20, "bold")).pack(anchor=tk.W)

tk.Label(title_frame, text="Smart Fall Detection & AI Anomaly System",

bg=BG_DARK, fg=TEXT_DIM, font=("Courier", 9)).pack(anchor=tk.W)

right_header = tk.Frame(header, bg=BG_DARK)

right_header.pack(side=tk.RIGHT, padx=20)

self.conn_dot = tk.Canvas(right_header, width=12, height=12,

bg=BG_DARK, highlightthickness=0)

self.conn_dot.pack(side=tk.LEFT, padx=(0,6))

self.conn_dot.create_oval(1,1,11,11, fill=DANGER, outline="", tags="dot")

self.conn_label = tk.Label(right_header, text="OFFLINE",

bg=BG_DARK, fg=DANGER,

font=("Courier", 11, "bold"))

self.conn_label.pack(side=tk.LEFT)

sep = tk.Canvas(self.root, height=1, bg=BG_DARK, highlightthickness=0)

sep.pack(fill=tk.X)

sep.create_line(0, 0, 2000, 0, fill=ACCENT, width=1)

# ── Main layout ──────────────────────────

main = tk.Frame(self.root, bg=BG_DARK)

main.pack(fill=tk.BOTH, expand=True, padx=12, pady=8)

left = tk.Frame(main, bg=BG_DARK)

left.pack(side=tk.LEFT, fill=tk.BOTH, expand=True)

# ── Connection bar ───────────────────────

conn_bar = tk.Frame(left, bg=BG_PANEL, pady=8)

conn_bar.pack(fill=tk.X, pady=(0,8))

tk.Label(conn_bar, text="ESP32 IP", bg=BG_PANEL, fg=TEXT_DIM,

font=("Courier",9)).pack(side=tk.LEFT, padx=(12,4))

self.ip_entry = tk.Entry(conn_bar, textvariable=self.esp32_ip,

bg=BG_CARD, fg=ACCENT, font=("Courier",11),

width=16, insertbackground=ACCENT,

relief=tk.FLAT, bd=4)

self.ip_entry.pack(side=tk.LEFT, padx=4)

tk.Button(conn_bar, text="[ CONNECT ]", bg=BG_PANEL, fg=ACCENT2,

font=("Courier",10,"bold"), command=self.connect,

relief=tk.FLAT, bd=0, cursor="hand2").pack(side=tk.LEFT, padx=8)

tk.Button(conn_bar, text="[ DISCONNECT ]", bg=BG_PANEL, fg=DANGER,

font=("Courier",10,"bold"), command=self.disconnect,

relief=tk.FLAT, bd=0, cursor="hand2").pack(side=tk.LEFT)

self.time_label = tk.Label(conn_bar, text="", bg=BG_PANEL, fg=TEXT_DIM,

font=("Courier",9))

self.time_label.pack(side=tk.RIGHT, padx=12)

# ── Charts ────────────────────────────────

self.fig = Figure(figsize=(8,5), facecolor=BG_DARK)

self.fig.subplots_adjust(hspace=0.4, left=0.08, right=0.97,

top=0.92, bottom=0.08)

self.plot_ax1 = self.fig.add_subplot(2,1,1)

self.plot_ax2 = self.fig.add_subplot(2,1,2)

for ax in [self.plot_ax1, self.plot_ax2]:

ax.set_facecolor(BG_PANEL)

ax.tick_params(colors=TEXT_DIM, labelsize=7)

for spine in ax.spines.values():

spine.set_edgecolor(TEXT_DIM)

spine.set_linewidth(0.5)

ax.grid(color=BG_CARD, linewidth=0.5, alpha=0.8)

self.canvas = FigureCanvasTkAgg(self.fig, master=left)

self.canvas.get_tk_widget().configure(bg=BG_DARK)

self.canvas.get_tk_widget().pack(fill=tk.BOTH, expand=True)

# ── Right panel ───────────────────────────

right = tk.Frame(main, bg=BG_DARK, width=300)

right.pack(side=tk.RIGHT, fill=tk.Y, padx=(10,0))

right.pack_propagate(False)

self._section_label(right, "PATIENT STATUS")

self.status_frame = tk.Frame(right, bg=BG_CARD, pady=16)

self.status_frame.pack(fill=tk.X, pady=(2,8))

self.status_label = tk.Label(self.status_frame, text="NORMAL",

bg=BG_CARD, fg=ACCENT2,

font=("Courier",24,"bold"))

self.status_label.pack()

self.status_sub = tk.Label(self.status_frame, text="All systems nominal",

bg=BG_CARD, fg=TEXT_DIM,

font=("Courier",8))

self.status_sub.pack()

self._section_label(right, "AI ANOMALY DETECTION")

self.anomaly_frame = tk.Frame(right, bg=BG_CARD, pady=10)

self.anomaly_frame.pack(fill=tk.X, pady=(2,8))

self.anomaly_icon = tk.Label(self.anomaly_frame, text="◉",

bg=BG_CARD, fg=ACCENT2,

font=("Courier",14))

self.anomaly_icon.pack()

self.anomaly_label = tk.Label(self.anomaly_frame, text="Monitoring...",

bg=BG_CARD, fg=ACCENT,

font=("Courier",11,"bold"))

self.anomaly_label.pack()

self._section_label(right, "LIVE SENSOR DATA")

readings_frame = tk.Frame(right, bg=BG_CARD, pady=8)

readings_frame.pack(fill=tk.X, pady=(2,8))

self.reading_bars = {}

for name, color, label in [("ax",AX_COLOR,"Ax"),("ay",AY_COLOR,"Ay"),

("az",AZ_COLOR,"Az"),("mag",MAG_COLOR,"|a|")]:

row = tk.Frame(readings_frame, bg=BG_CARD)

row.pack(fill=tk.X, padx=10, pady=3)

tk.Label(row, text=label, bg=BG_CARD, fg=color,

font=("Courier",10,"bold"), width=4,

anchor=tk.W).pack(side=tk.LEFT)

bar_canvas = tk.Canvas(row, height=14, bg=BG_PANEL,

highlightthickness=0, width=140)

bar_canvas.pack(side=tk.LEFT, padx=4)

val_label = tk.Label(row, text="0.00 g", bg=BG_CARD, fg=color,

font=("Courier",10), width=8, anchor=tk.E)

val_label.pack(side=tk.RIGHT)

self.reading_bars[name] = (bar_canvas, val_label, color)

self._section_label(right, "EVENT LOG")

log_frame = tk.Frame(right, bg=BG_CARD)

log_frame.pack(fill=tk.BOTH, expand=True, pady=(2,0))

self.log_text = tk.Text(log_frame, bg=BG_DARK, fg=TEXT_MID,

font=("Courier",8), state=tk.DISABLED,

relief=tk.FLAT, selectbackground=BG_PANEL)

self.log_text.pack(fill=tk.BOTH, expand=True, padx=6, pady=6)

self.log_text.tag_config("emergency", foreground=DANGER)

self.log_text.tag_config("warning", foreground=WARN)

self.log_text.tag_config("info", foreground=ACCENT)

self.log_text.tag_config("normal", foreground=ACCENT2)

def _section_label(self, parent, text):

frame = tk.Frame(parent, bg=BG_DARK)

frame.pack(fill=tk.X, pady=(4,0))

tk.Label(frame, text=f" {text}", bg=BG_DARK, fg=TEXT_DIM,

font=("Courier",8,"bold")).pack(side=tk.LEFT)

line = tk.Canvas(frame, height=1, bg=BG_DARK, highlightthickness=0)

line.pack(side=tk.LEFT, fill=tk.X, expand=True, padx=6)

line.create_line(0, 0, 500, 0, fill=TEXT_DIM, width=1)

def animate_ui(self):

self.pulse_angle += 0.05

self.alert_flash += 0.08

self.pulse_canvas.delete("all")

cx, cy, r = 20, 20, 14

pr = r + 4 + int(3 * math.sin(self.pulse_angle))

color = ACCENT if self.connected else TEXT_DIM

self.pulse_canvas.create_oval(cx-pr,cy-pr,cx+pr,cy+pr, outline=color, width=1)

self.pulse_canvas.create_oval(cx-r, cy-r, cx+r, cy+r, fill=color, outline="")

self.time_label.config(text=time.strftime(" %H:%M:%S"))

if self.current_anomaly:

alpha = int(127 + 127 * math.sin(self.alert_flash))

hex_color = f"#{alpha:02x}{alpha//3:02x}00"

self.anomaly_icon.config(fg=hex_color)

for name, (bar, val_label, color) in self.reading_bars.items():

try:

self.anim_vals[name].update(

float(val_label.cget("text").replace(" g","") or 0))

except: pass

bar.delete("all")

bar.create_rectangle(0, 0, 140, 14, fill=BG_PANEL, outline="")

raw = abs(self.anim_vals[name].current)

w = min(int(raw * 70), 140)

if w > 0: bar.create_rectangle(0, 2, w, 12, fill=color, outline="")

self.root.after(50, self.animate_ui)

def update_plots(self):

if len(self.time_data) > 2:

t = list(self.time_data)

self.plot_ax1.clear()

self.plot_ax1.set_facecolor(BG_PANEL)

self.plot_ax1.fill_between(t, list(self.ax_data), alpha=0.15, color=AX_COLOR)

self.plot_ax1.fill_between(t, list(self.ay_data), alpha=0.15, color=AY_COLOR)

self.plot_ax1.plot(t, list(self.ax_data), color=AX_COLOR,

linewidth=1.2, label="Ax")

self.plot_ax1.plot(t, list(self.ay_data), color=AY_COLOR,

linewidth=1.2, label="Ay")

self.plot_ax1.plot(t, list(self.az_data), color=AZ_COLOR,

linewidth=1.2, label="Az")

self.plot_ax1.axhline(1.8, color=DANGER, linestyle="--",

linewidth=0.8, alpha=0.6)

self.plot_ax1.axhline(0.6, color=WARN, linestyle="--",

linewidth=0.8, alpha=0.6)

self.plot_ax1.set_title("ACCELERATION (g)", color=TEXT_MID,

fontsize=8, fontfamily="monospace", pad=4)

self.plot_ax1.legend(facecolor=BG_CARD, labelcolor=TEXT_LIGHT,

fontsize=7, loc="upper right", framealpha=0.8)

self.plot_ax1.tick_params(colors=TEXT_DIM, labelsize=7)

for spine in self.plot_ax1.spines.values():

spine.set_edgecolor(TEXT_DIM); spine.set_linewidth(0.5)

self.plot_ax1.grid(color=BG_CARD, linewidth=0.5)

self.plot_ax2.clear()

self.plot_ax2.set_facecolor(BG_PANEL)

self.plot_ax2.fill_between(t, list(self.mag_data),

alpha=0.2, color=MAG_COLOR)

self.plot_ax2.plot(t, list(self.mag_data), color=MAG_COLOR, linewidth=1.5)

self.plot_ax2.axhline(1.8, color=DANGER, linestyle="--",

linewidth=0.8, alpha=0.6, label="Impact threshold")

self.plot_ax2.axhline(0.6, color=WARN, linestyle="--",

linewidth=0.8, alpha=0.6, label="Freefall threshold")

self.plot_ax2.set_title("MAGNITUDE |a| (g)", color=TEXT_MID,

fontsize=8, fontfamily="monospace", pad=4)

self.plot_ax2.legend(facecolor=BG_CARD, labelcolor=TEXT_LIGHT,

fontsize=7, loc="upper right", framealpha=0.8)

self.plot_ax2.tick_params(colors=TEXT_DIM, labelsize=7)

for spine in self.plot_ax2.spines.values():

spine.set_edgecolor(TEXT_DIM); spine.set_linewidth(0.5)

self.plot_ax2.grid(color=BG_CARD, linewidth=0.5)

self.fig.tight_layout(pad=1.5)

self.canvas.draw()

self.root.after(150, self.update_plots)

def log(self, msg, tag="info"):

ts = time.strftime("%H:%M:%S")

self.log_text.configure(state=tk.NORMAL)

self.log_text.insert(tk.END, f"[{ts}] {msg}\n", tag)

self.log_text.see(tk.END)

self.log_text.configure(state=tk.DISABLED)

def connect(self):

ip = self.esp32_ip.get().strip()

threading.Thread(target=self._connect_thread,

args=(ip,), daemon=True).start()

def _connect_thread(self, ip):

try:

self.sock = socket.socket(socket.AF_INET, socket.SOCK_STREAM)

self.sock.settimeout(5)

self.sock.connect((ip, ESP32_PORT))

self.sock.settimeout(None)

self.connected = True

self.root.after(0, self._on_connected, ip)

self._receive_loop()

except Exception as e:

self.connected = False

self.root.after(0, self._on_failed, str(e))

def _on_connected(self, ip):

self.conn_label.config(text="CONNECTED", fg=ACCENT2)

self.conn_dot.itemconfig("dot", fill=ACCENT2)

self.log(f"Connected to {ip}:{ESP32_PORT}", "normal")

def _on_failed(self, err):

self.conn_label.config(text="FAILED", fg=DANGER)

self.conn_dot.itemconfig("dot", fill=DANGER)

self.log(f"Failed: {err}", "emergency")

def disconnect(self):

self.connected = False

try: self.sock.close()

except: pass

self.conn_label.config(text="OFFLINE", fg=DANGER)

self.conn_dot.itemconfig("dot", fill=DANGER)

self.log("Disconnected", "warning")

def _receive_loop(self):

buf = ""

while self.connected:

try:

chunk = self.sock.recv(4096).decode("utf-8", errors="ignore")

if not chunk: break

buf += chunk

while "\n" in buf:

line, buf = buf.split("\n", 1)

line = line.strip()

if line:

try:

data = json.loads(line)

self.root.after(0, lambda d=data: self.process(d))

except: pass

except: break

self.connected = False

self.root.after(0, lambda: self.conn_label.config(text="OFFLINE",fg=DANGER))

def process(self, data):

msg_type = data.get("type", "")

if msg_type == "sensor":

ax=data.get("ax",0); ay=data.get("ay",0)

az=data.get("az",0); mag=data.get("mag",0)

t = time.time() - self.start_time

self.ax_data.append(ax); self.ay_data.append(ay)

self.az_data.append(az); self.mag_data.append(mag)

self.time_data.append(t)

self.reading_bars["ax"][1].config(text=f"{ax:+.2f} g")

self.reading_bars["ay"][1].config(text=f"{ay:+.2f} g")

self.reading_bars["az"][1].config(text=f"{az:+.2f} g")

self.reading_bars["mag"][1].config(text=f"{mag:.2f} g")

state = data.get("state", 1)

state_map = {

0: ("CALIBRATING", WARN, "Learning movement patterns..."),

1: ("NORMAL", ACCENT2, "All systems nominal"),

2: ("FREEFALL", WARN, "Free-fall detected!"),

3: ("IMPACT", DANGER, "Impact detected!"),

4: ("FALL!", DANGER, "Fall confirmed!"),

5: ("EMERGENCY", DANGER, "EMERGENCY - Send help!"),

}

label, color, sub = state_map.get(state, ("UNKNOWN", TEXT_DIM, ""))

self.status_label.config(text=label, fg=color)

self.status_sub.config(text=sub)

elif msg_type == "anomaly":

anomaly = data.get("anomaly", "")

labels = {"unusual_movement":"Unusual Movement",

"tremor":"Tremor Detected",

"no_movement":"No Movement!",

"slow_collapse":"Slow Collapse!"}

label = labels.get(anomaly, anomaly)

self.current_anomaly = label

self.anomaly_label.config(text=label, fg=WARN)

self.anomaly_icon.config(fg=WARN)

self.log(f"AI: {label}", "warning")

self.root.after(10000, self._clear_anomaly)

elif msg_type == "fall":

peak = data.get("peakG", 0)

self.log(f"FALL CONFIRMED! Peak: {peak:.2f}g", "emergency")

self.status_label.config(text="FALL!", fg=DANGER)

elif msg_type == "emergency":

peak = data.get("peakG", 0)

self.log(f"EMERGENCY! Peak: {peak:.2f}g", "emergency")

self.status_label.config(text="EMERGENCY", fg=DANGER)

elif msg_type == "calibration":

mean=data.get("mean",0); std=data.get("std",0)

self.log(f"AI calibrated: mean={mean:.2f} std={std:.2f}", "normal")

self.anomaly_label.config(text="AI Active", fg=ACCENT2)

self.anomaly_icon.config(fg=ACCENT2)

def _clear_anomaly(self):

self.current_anomaly = ""

self.anomaly_label.config(text="Monitoring...", fg=ACCENT)

self.anomaly_icon.config(fg=ACCENT2)

if __name__ == "__main__":

root = tk.Tk()

app = GuardBandDashboard(root)

root.mainloop()

References

[1] A. K. Bourke and G. M. Lyons, "A threshold-based fall-detection algorithm using a bi-axial gyroscope sensor," Medical Engineering & Physics, vol. 30, no. 1, pp. 84-90, 2008.

[2] M. Kangas et al., "Comparison of low-complexity fall detection algorithms for body attached accelerometers," Gait & Posture, vol. 28, no. 2, pp. 285-291, 2008.

[3] M. Mubashir, L. Shao, and L. Seed, "A survey on fall detection: Principles and approaches," Neurocomputing, vol. 100, pp. 144-152, 2013.

[4] R. Igual, C. Medrano, and I. Plaza, "Challenges, issues and trends in fall detection systems," BioMedical Engineering OnLine, vol. 12, no. 1, p. 66, 2013.

[5] Espressif Systems, "ESP32 Technical Reference Manual," v5.2, 2024.

[6] InvenSense, "MPU-6000 and MPU-6050 Product Specification Revision 3.4," 2013.

GuardBand AI — Smart Fall Detection & AI Anomaly System | Amro Kamal Jallad | Abu Dhabi University, 2026
